theNeonTerminal/ESP32-Audio-Player/BOM.csv

Item | Qty | Supplier | Cost/item | Total Cost | link
SD Card Reader Module | 1 | amazon.in | $1.20 | $1.20 | https://www.amazon.in/RobomallsTM-Micro-Module-Aiduino-Interface/dp/B0H9H46Q3X
ESP32 WROOM | 1 | amazon.in | $5.20 | $5.20 | https://www.amazon.in/gp/product/B0HD7QC26L/ref=ewc_pr_img_2?smid=A3C7Z4RVM9A3G1&psc=1
Battery | 1 | amazon.in | $1.10 | $1.10 | https://www.amazon.in/gp/product/B0HC6RRYJL/ref=ox_sc_act_title_5?smid=A2J0MMX5A7G1FN&psc=1
Mechanical Switches | 1 | amazon.in | $5.30 | $5.30 | https://www.amazon.in/gp/product/B0H1X4CW7W/ref=ox_sc_act_image_3?smid=A16FKXBMFHBYH0&psc=1
PCB | 1 | jlcpcb.com | $13.50 | $13.50 | https://jlcpcb.com
PCM5102a | 1 | hubtronics.com | $4.70 | $4.70 | https://hubtronics.in/pcm5102-i2s-digital-audio-dac-decoder-module
TP4056 Charger | 1 | robu.in | $0.20 | $0.20 | https://robu.in/product/tp4056-1a-li-ion-lithium-battery-charging-module-with-current-protection-type-c/
OLED SSD1306 | 1 | robu.in | $2.70 | $2.70 | https://robu.in/product/0-96-oled-display-module/
Estimated total shipping | 1 |  |  | $4.00
