theNeonTerminal/ESP32-Audio-Player/ESP32 Audio Player/ESP32 Audio Player.kicad_pcb

## KiCad design ESP32 Audio Player/ESP32 Audio Player.kicad_pcb (2026-11-01)

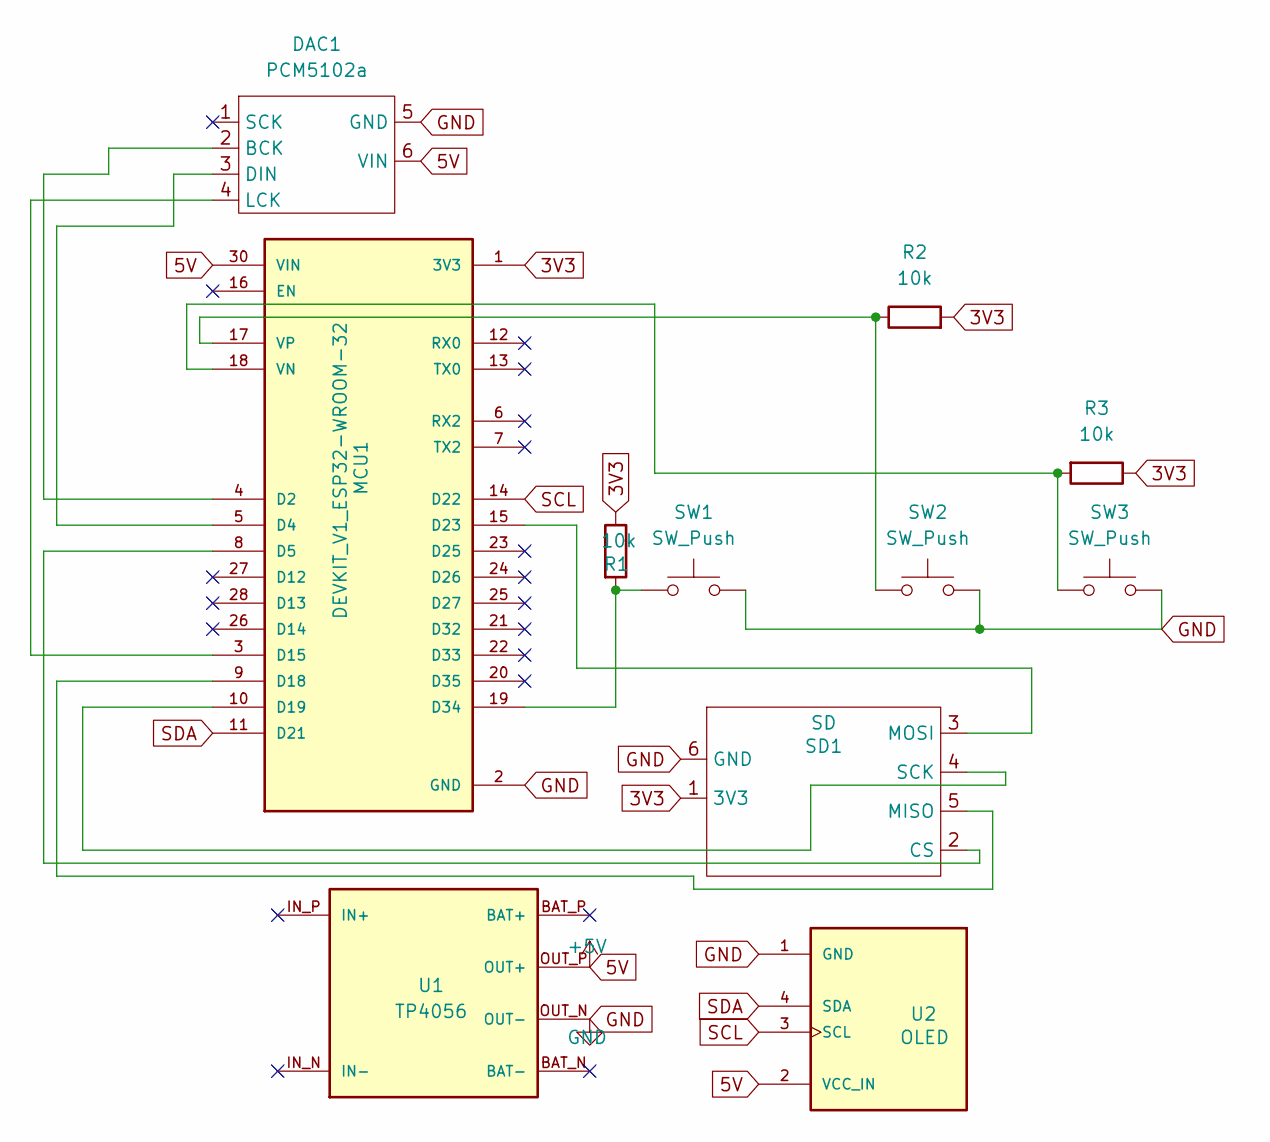
[picture p7: schematic ESP32 Audio Player.kicad_sch]

Parts:
DAC1: PCM5102a; GY-PCM5102
MCU1: DEVKIT_V1_ESP32-WROOM-32; ESP32-30-pin
R1, R2, R3: 10k; R_Axial_DIN0204_L3.6mm_D1.6mm_P7.62mm_Horizontal
SD1: SD; MODULE_MICROSD_SPI_OR_SDIO_CARD
SW1, SW2, SW3: SW_Push; SW_Cherry_MX_PCB_1.00u
U1: TP4056; MODULE_TP4056_MICRO-USB_CHARGER_-_1A
U2: OLED; OLED-SSD1306; PARTREV 2018-09-10

Connections:
3V3: MCU1.1 (3V3), R1.1, R2.2, R3.1, SD1.1 (3V3)
5V: DAC1.6 (VIN), MCU1.30 (VIN), U1.OUT_P (OUT+), U2.2 (VCC_IN)
GND: DAC1.5 (GND), MCU1.2 (GND), MCU1.29 (GND), SD1.6 (GND), SW1.2, SW2.2, SW3.2, U1.OUT_N (OUT-), U2.1 (GND)
unnamed: DAC1.2 (BCK), MCU1.4 (D2)
unnamed: DAC1.3 (DIN), MCU1.5 (D4)
unnamed: DAC1.4 (LCK), MCU1.3 (D15)
unnamed: MCU1.8 (D5), SD1.2 (CS)
unnamed: MCU1.9 (D18), SD1.5 (MISO)
unnamed: MCU1.10 (D19), SD1.4 (SCK)
unnamed: MCU1.15 (D23), SD1.3 (MOSI)
unnamed: MCU1.19 (D34), R1.2, SW1.1
unnamed: MCU1.18 (VN), R3.2, SW3.1
unnamed: MCU1.17 (VP), R2.1, SW2.1
SCL: MCU1.14 (D22), U2.3 (SCL)
SDA: MCU1.11 (D21), U2.4 (SDA)

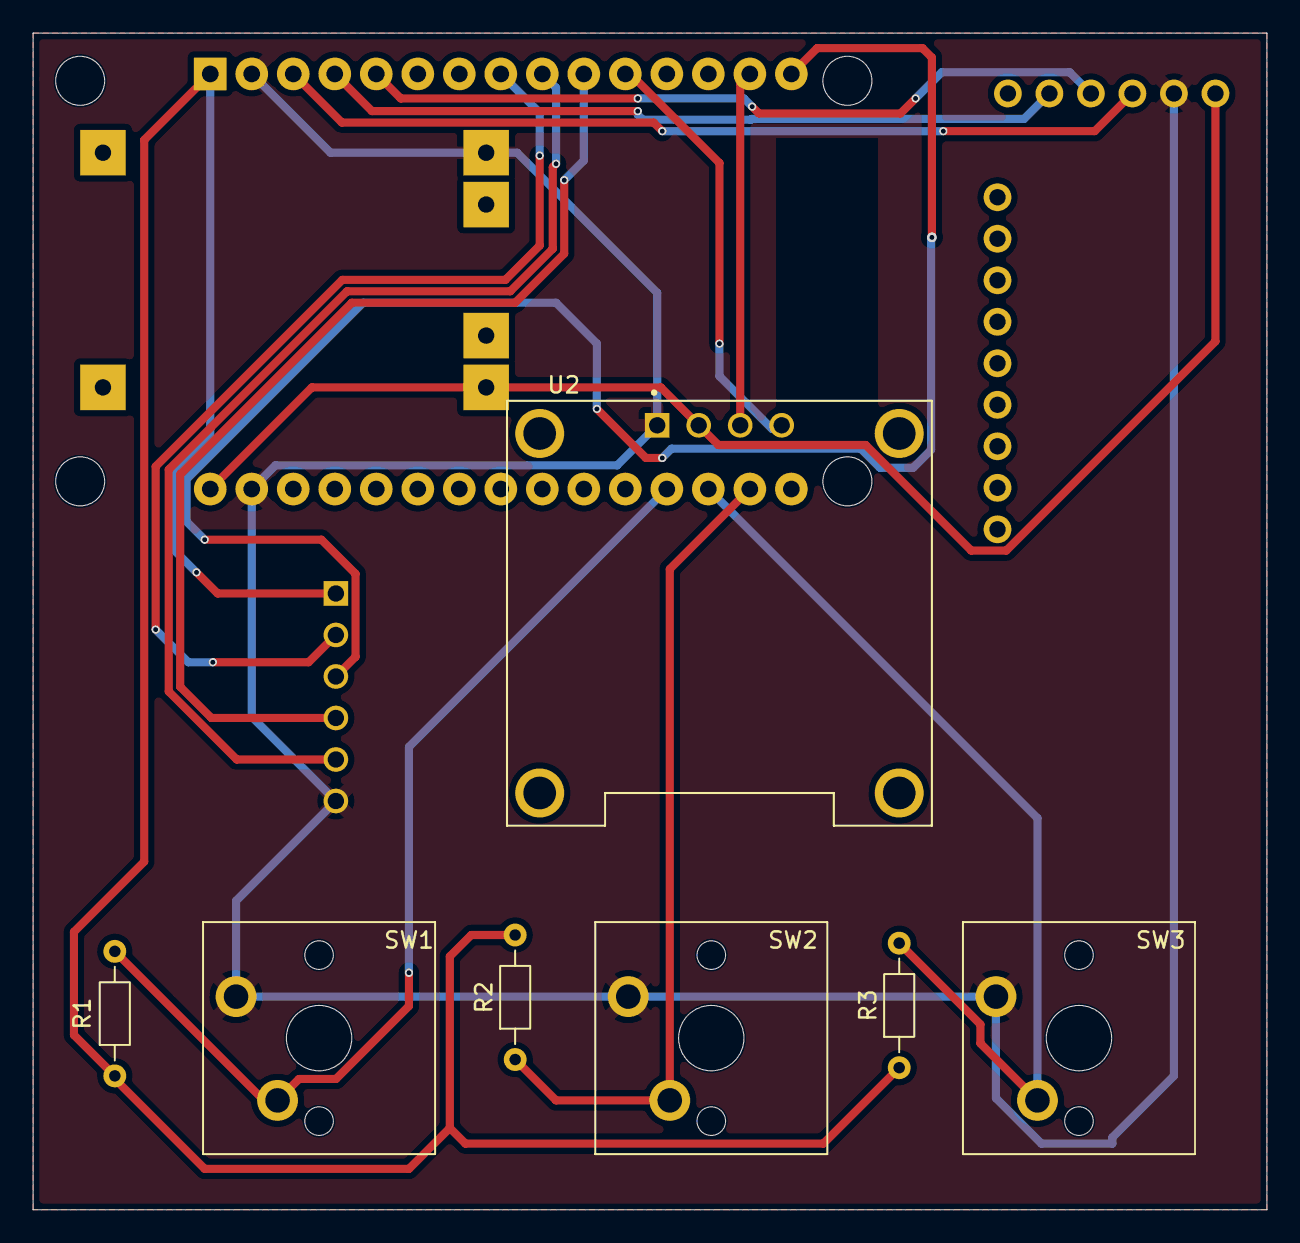
[picture p8: board ESP32 Audio Player.kicad_pcb from above]

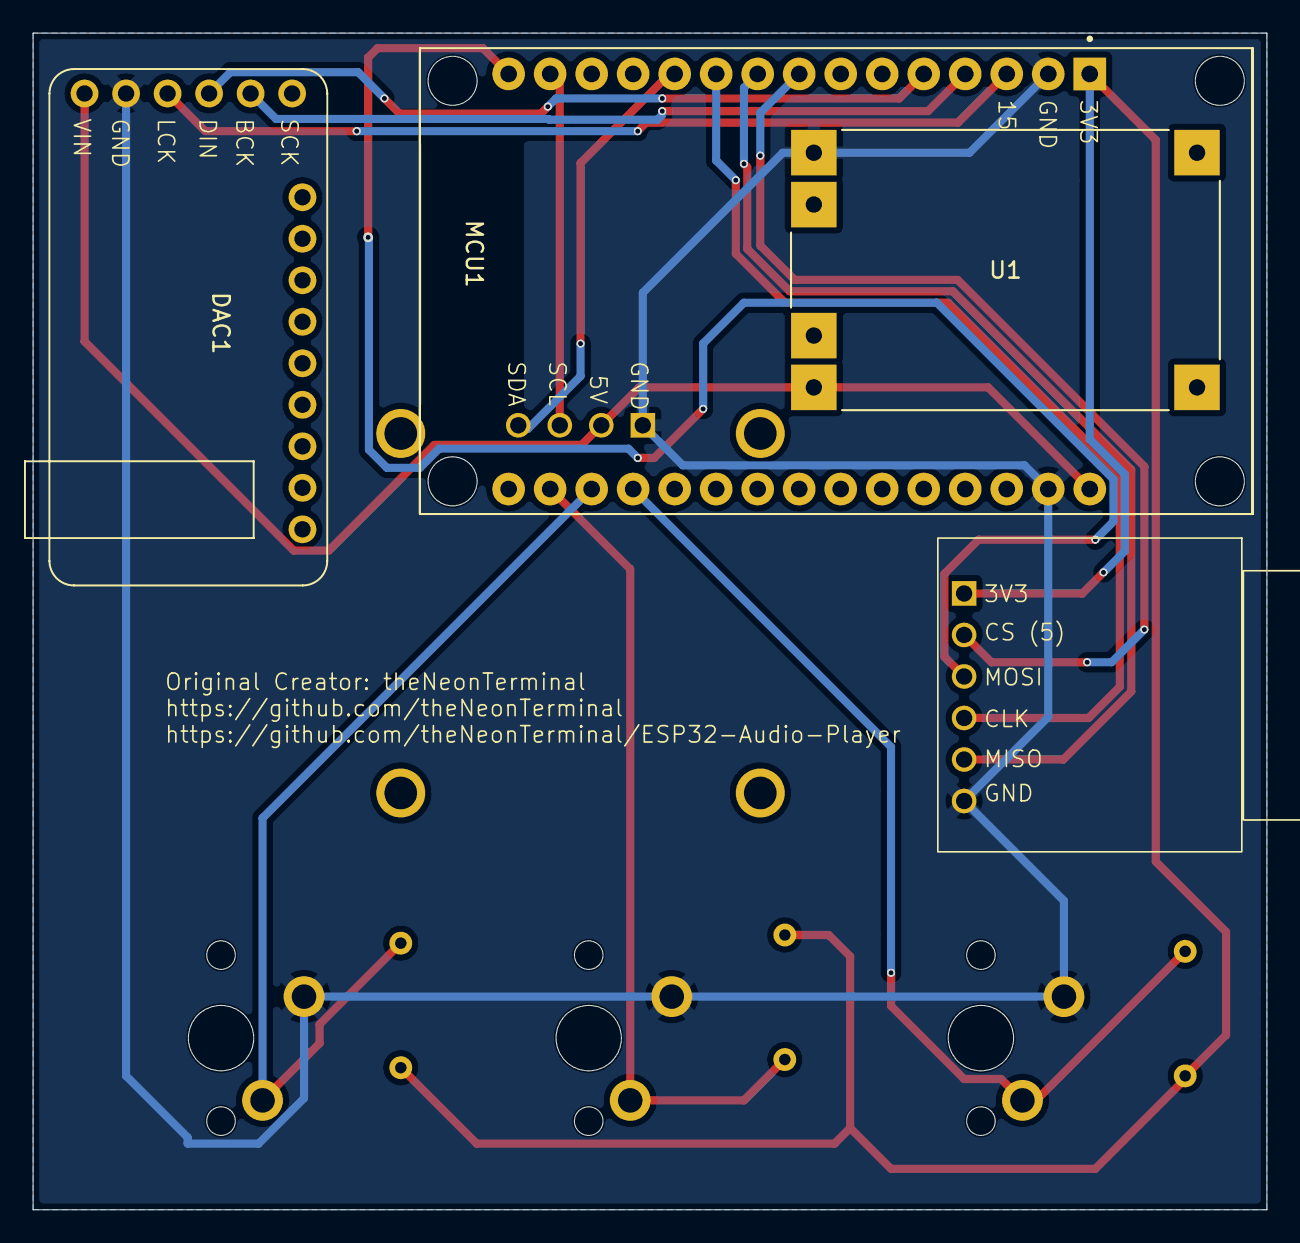
[picture p9: board ESP32 Audio Player.kicad_pcb from below]

Board: 2 copper layers, 75.5 x 72.0 mm, 11 parts (4 on the bottom side), 15 nets.
