theNeonTerminal/ESP32-Audio-Player/JOURNAL.md

# Mini ESP32 Audio Player: devlog

<!-- Generated by Half Life from project cmvfaqs0y0bce01rcuumdj9uw. Edits here are overwritten on the next sync. -->
<!-- Generated: 2026-11-01T17:19:26.151Z -->

> [!NOTE]
> This devlog is mirrored from [Half Life](https://halflife.hackclub.com) ([open the project](https://halflife.hackclub.com/projects/cmvfaqs0y0bce01rcuumdj9uw)). Editing it here will not change the platform's copy, and the next sync overwrites this file.

> An ESP32 Based audio player that can play .mp3 and .wav music files store in an SD Card and runs it out via a speaker or Headphone jack provided

| Week | Tier | Hours logged | Entries |
| --- | --- | --- | --- |
| Week 3 | Tier 1 | 17h | 7 |

## Contents

1. [2026-10-20: ](#2026-10-20-imagehttpshalflifehackclub-assetscomsessionssg2yt)
2. [2026-10-20: Finally completed the function to read only `.wav` and `.mp3` files from the given SD card by looking online at what other people did, took a little longer than expected](#2026-10-20-finally-completed-the-function-to-read-only-wav-a)
3. [2026-10-20: Managed to get the max98357a amplifier working via code, now I can will start with the main part of the program - handling button presses, managing SD card audio and then go to PCB.](#2026-10-20-managed-to-get-the-max98357a-amplifier-working-vi)
4. [2026-10-21: ](#2026-10-21-imagehttpshalflifehackclub-assetscomsessionssg2yt)
5. [2026-10-22: ](#2026-10-22-imagehttpshalflifehackclub-assetscomsessionssg2yt)
6. [2026-10-24: footprint](#2026-10-24-footprinthttpshalflifehackclub-assetscomsessionss)
7. [2026-11-01: Completed all changes requested by reviewer, heres a small breakdown:](#2026-11-01-completed-all-changes-requested-by-reviewer-heres)

## Design

### 2026-10-20: 

**2h**





Got the SD card and OLED display up and running, now I will test the max98357a amplifier and update how did it go
OLED display working (so wiring and code is correct, same with others as well) and showing things its meant to show and sd card reading is working
most of the time, for me its really a wiring issue, where the wire I use either isnt internally connected somehow or isnt fully touching the pads, so thats ruled out
After I get it working, Ill make some utility functions and start on the projects main firmware
Since theres only code for now Ill only attach random screenshots i take in code

### 2026-10-20: Finally completed the function to read only `.wav` and `.mp3` files from the given SD card by looking online at what other people did, took a little longer than expected

**2h**

Finally completed the function to read only `.wav` and `.mp3` files from the given SD card by looking online at what other people did, took a little longer than expected
Now I will move to checking how to make the amplifier work and move on to the main project part

Had some difficulties to filer the SD card read function provided in SD card example code, since it does not check for any extension, a (not so) quick google search and helped to fix this issue

FUTURE NOTE: I did not get much time after completing the project to implement the menu, so Ill leave the part commented, so i can later implement a "Select Song" menu





### 2026-10-20: Managed to get the max98357a amplifier working via code, now I can will start with the main part of the program - handling button presses, managing SD card audio and then go to PCB.

**3h**

Managed to get the max98357a amplifier working via code, now I can will start with the main part of the program - handling button presses, managing SD card audio and then go to PCB.
Used a bare minimum I2S driver, had to do a lot of work to make it work for the 1st time, but now I will search for a library that already does most of the hardwork







### 2026-10-21: 

**3h**







Mostly Completed the firmware part - everything is working together, OLED shows currently playing song, amplifier/speaker also works properly along with SD card reading

Used the arduino-audio-tools library on github, a real lifesaver, else I had to spent an additions 4-5 hours in an attempt to implement this feature (reading from sd card and playing it in speaker via I2S)

Now I will move on the building the PCB and the project will be completed

### 2026-10-22: 

**3h**



Fully Completed the PCB, checking out both firmware and PCB
making the pcb wasnt hard, except it a took a little bit of time, but other than that it went well, I jsut simply used a cheap trick to save some pcb space, like make the pcb a little more compact and look cleaner dimentionally
for reviewers: I'll attach an image im trying to tell in the following journals
I still need to make a few minor adjustments to the PCB before submitting the project.
Things to do before submitting: proper README and some finishing touches to OLED UI





### 2026-10-24: footprint

**2h**

footprint

Added READE.md and Made some changes to the PCB - added a PCM5102a to replace the original Max98357a amplifer - which runs a speaker, not the best for this project and the headphone jack is far more practical

3d2

### 2026-11-01: Completed all changes requested by reviewer, heres a small breakdown:

**2h**

Completed all changes requested by reviewer, heres a small breakdown:
- a proof of what Im trying to do with overlapping PCB footprints:  since it might cause some problems for other people to copy me, for now I'll simply write "needs female header pins", but later put an actual image of the finished product on github once I get the parts to make it more clear
In short, its intentional and tested
- Updated all journals from memory to add more details
- Updates README for more detials
- Updated code to add a limited refresh rate to OLED
- Updated PCB for pullup resistors
- Fixed BOM and missing drill files

NOTEs for reviwer: I happened to have a few of the parts with me, so I am including them in the BoM, but not for funding, $30 works fine. for charger to battery, Ill use the same trick and solder the wire directly on the module instead of the PCB, so it works as well
