theNeonTerminal/ESP32-Audio-Player/(commit log)

2026-10-19 Sync Mini ESP32 Audio Player from Half Life
    [BOM.csv]
2026-10-20 Added a for SD card .wav read
    [ESP32 Audio Player.kicad_pcb, ESP32 Audio Player.kicad_sch]
2026-10-22 Completed main firmware
    [ESP32 Audio Player.kicad_pcb, ESP32 Audio Player.kicad_sch]
2026-10-23 Completed PCB
    [ESP32 Audio Player.kicad_pcb]
2026-10-24 Added README and Updated PCB
    [ESP32 Audio Player.kicad_pcb, ESP32 Audio Player.kicad_sch]
2026-10-25 Added gerber files
    [ESP32 Audio Player-B_Cu.gbr, ESP32 Audio Player-B_Mask.gbr, ESP32 Audio Player-B_Paste.gbr, ESP32 Audio Player-B_Silkscreen.gbr, ESP32 Audio Player-Edge_Cuts.gbr, ESP32 Audio Player-F_Cu.gbr, ESP32 Audio Player-F_Mask.gbr, ESP32 Audio Player-F_Paste.gbr]
2026-11-01 Made a lot of changes
    [ESP32 Audio Player-B_Cu.gbr, ESP32 Audio Player-B_Mask.gbr, ESP32 Audio Player-B_Paste.gbr, ESP32 Audio Player-B_Silkscreen.gbr, ESP32 Audio Player-Edge_Cuts.gbr, ESP32 Audio Player-F_Cu.gbr, ESP32 Audio Player-F_Mask.gbr, ESP32 Audio Player-F_Paste.gbr]
